oberlab/xmas-badge/edu_resources/exercises.pdf

## Lötübung xmas-badge

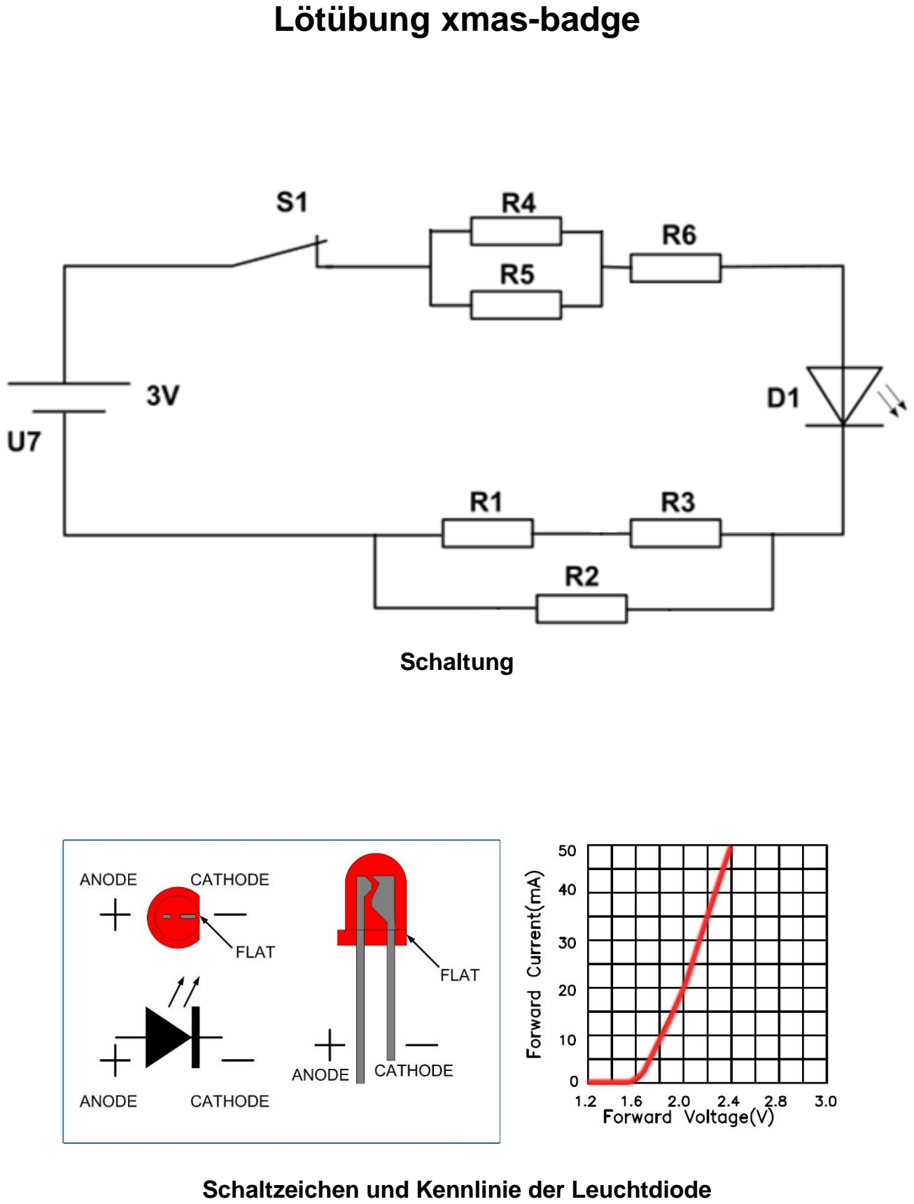
[picture p5: page 1]

Schaltung

Schaltzeichen und Kennlinie der Leuchtdiode

Aufgaben

1. Bestücke den Batteriehalter, den Schalter S1 und die rote LED D1.
2. Überbrücke R2.
3. Bei einer Batteriespannung von 3V soll der LED-Strom 30mA betragen. Berechne

den Wert für R6.

4. Löte R6 ein.
5. Schließe einen Strommesser anstelle von R4 an und überprüfe den LED-Strom.
6. Trenne die Brücke von R2 auf und bestimme den Widerstand R2 bei einen LED-

Strom von 12mA.

7. Löte R2 ein.
8. Überprüfe den Gesamtstrom.
9. Überbrücke R3.
10. Durch R1 soll der LED-Strom auf 15mA steigen. Welchen Wert hat R1?
11. Löte R1 ein und überprüfe den LED-Strom.
12. Entferne die Brücke bei R3.
13. Der Gesamtstrom soll sich durch R3 auf 13mA ändern. Welchen Wert hat R3?
14. Entferne den Strommesser bei R4.
15. Der Gesamtstrom soll sich durch die Bestückung von R4 und R5 auf 10mA ändern.

Welchen Wert hat R4 und R5?
