oberlab/xmas-badge/.svg2shenzhen-cache/images/F.Cu_g842.png

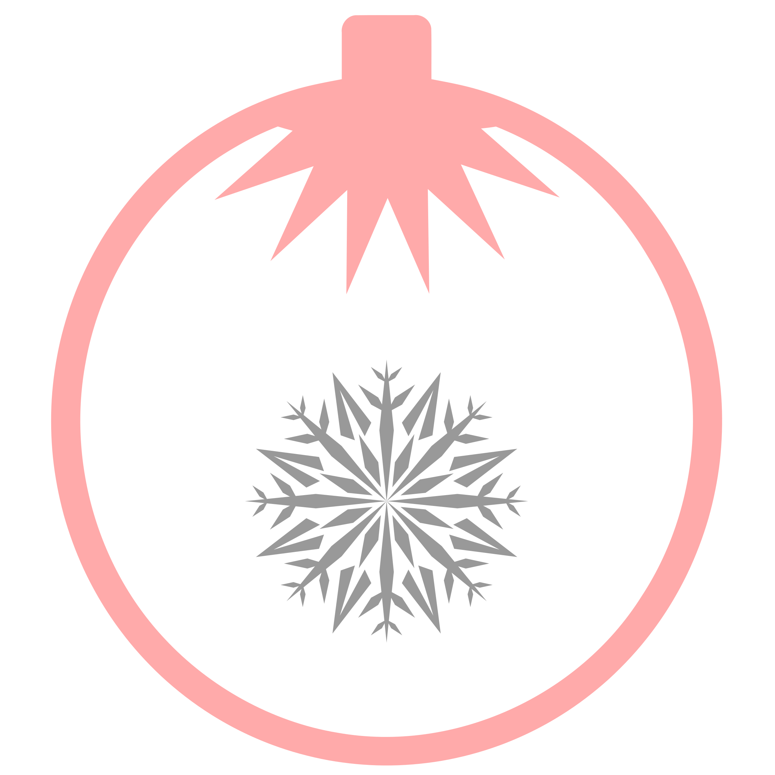
.svg2shenzhen-cache/images/F.Cu_g842.png
