oberlab/xmas-badge/.svg2shenzhen-cache/images/F.SilkS_g846.png

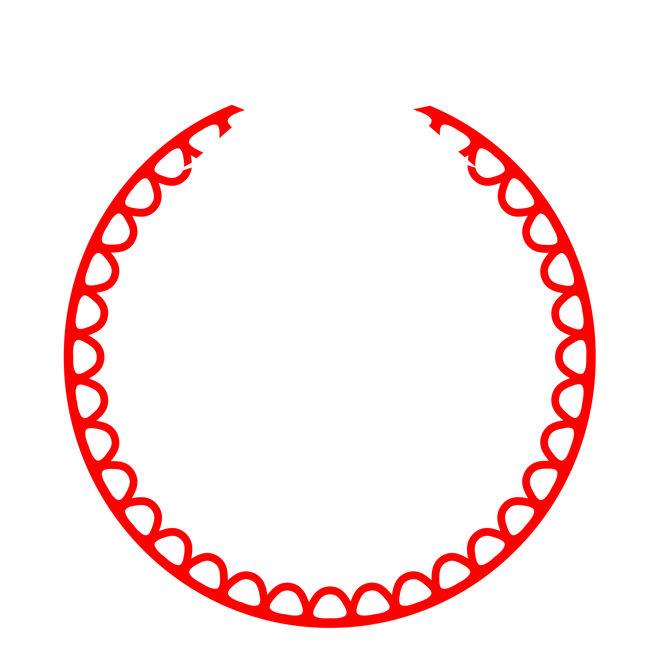
.svg2shenzhen-cache/images/F.SilkS_g846.png
