oberlab/xmas-badge/edu_resources/instructions.pdf

Lötübung xmas-badge

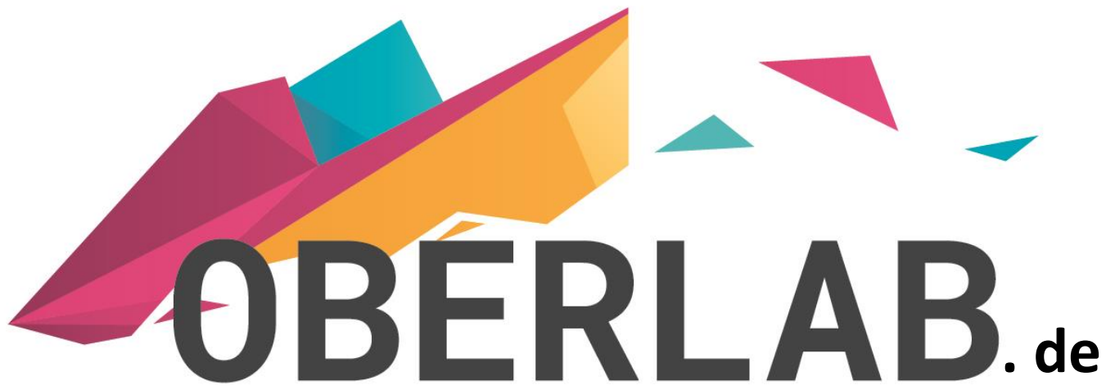
[picture p8: figure]
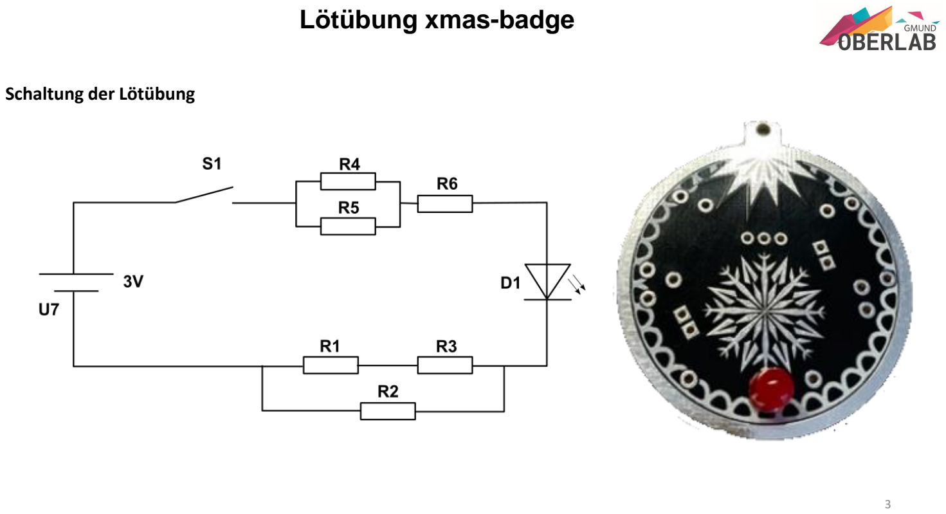
[picture p9: page 2]

Lötübung xmas-badge

Schaltung der Lötübung

Lötübung xmas-badge

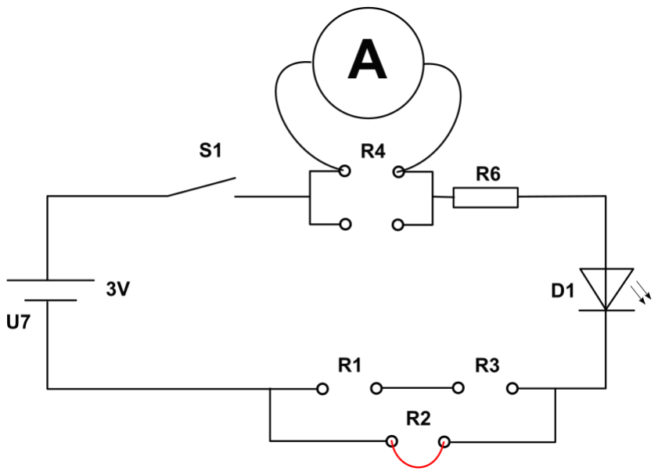
[picture p10: figure]

Ersatzschaltbild Aufgabe 1 - 5

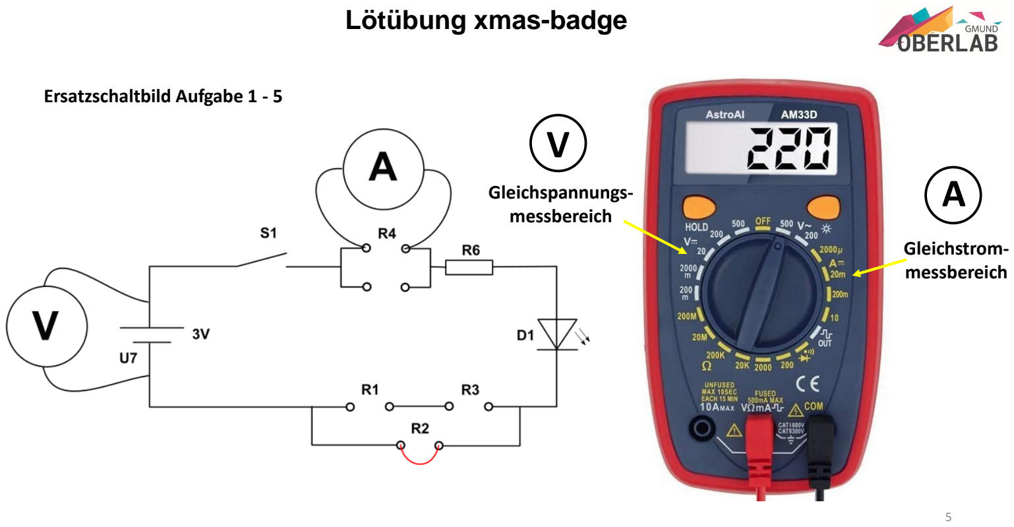
[picture p11: page 4]

Lötübung xmas-badge

Ersatzschaltbild Aufgabe 1 - 5

Gleichspannungs-messbereich
Gleichstrom-messbereich

V
A

Lötübung xmas-badge

Die LED:

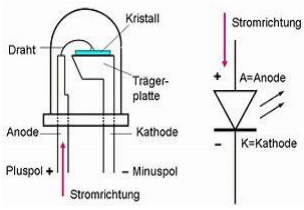
[picture p12: figure]

Lötübung xmas-badge

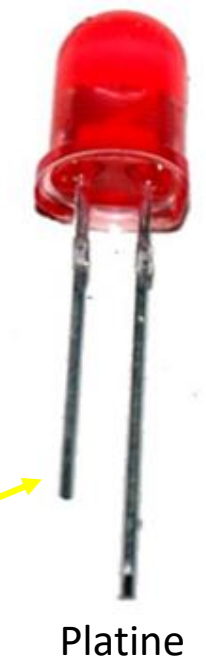
[picture p13: figure]
Platine

Die LED:

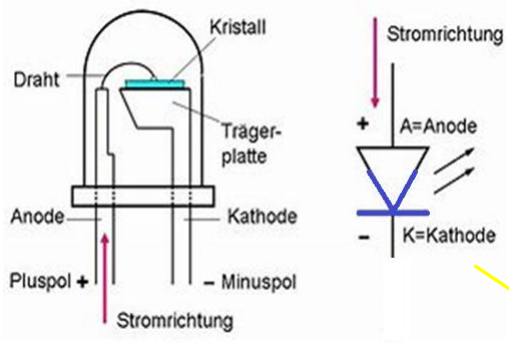
[picture p14: figure]

Lötübung xmas-badge

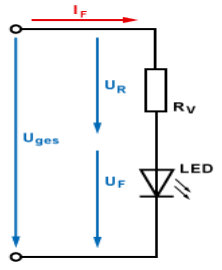
[picture p15: figure]

Mit einem Vorwiderstand wird der Durchlassstrom IF , der durch die Leuchtdiode fließt, begrenzt.
Bei der Widerstandsbestimmung muss die jeweilige Durchlassspannung UF berücksichtigt werden.

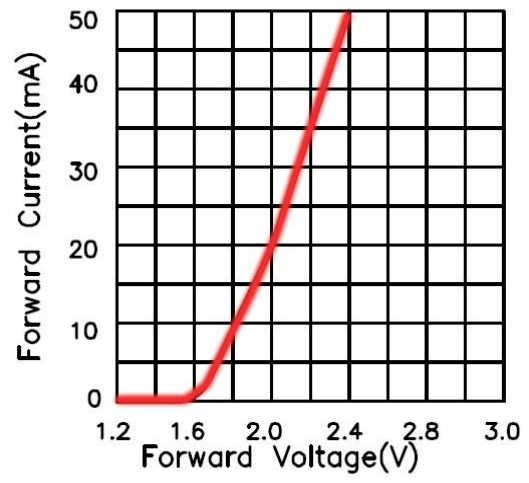
[picture p16: figure]

Rv =

Uges − UF
IF

Lötübung xmas-badge

Mit einem Vorwiderstand wird der Durchlassstrom IF , der durch die Leuchtdiode fließt, begrenzt.
Bei der Widerstandsbestimmung muss die jeweilige Durchlassspannung UF berücksichtigt werden.

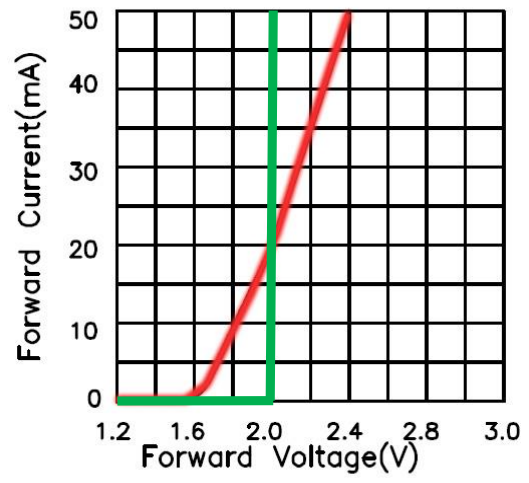
[picture p17: figure]

Rv =

Uges − UF
IF

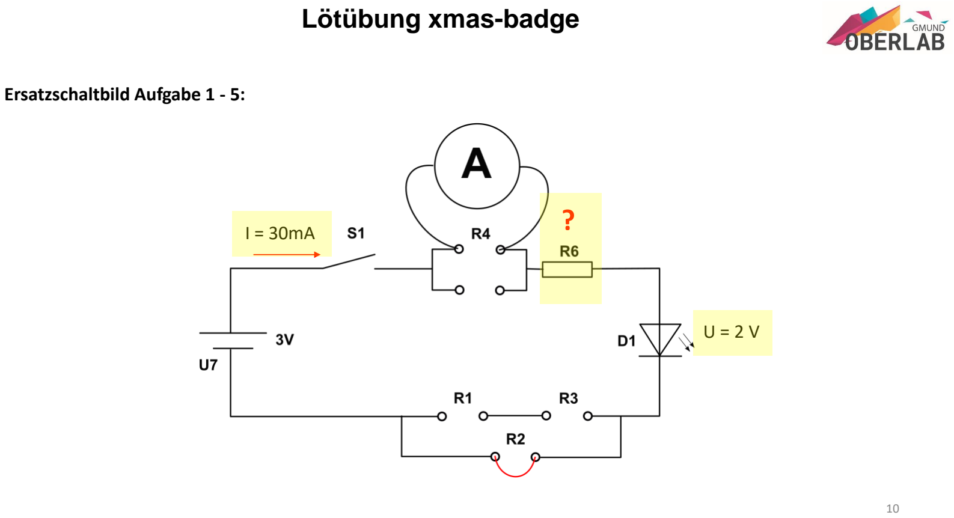
[picture p18: page 9]

Lötübung xmas-badge

Ersatzschaltbild Aufgabe 1 - 5:

I = 30mA | ?

U = 2 V

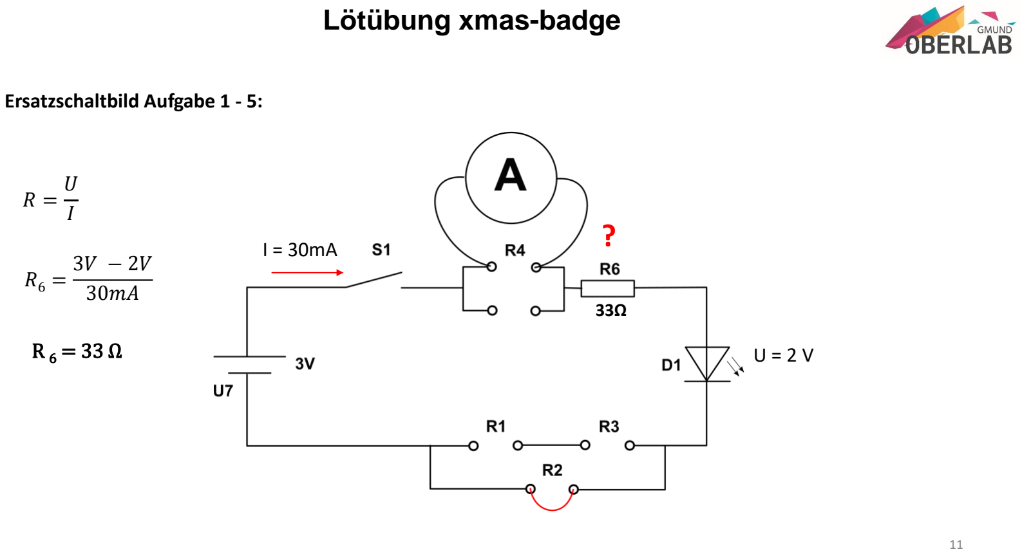
[picture p19: page 10]

Lötübung xmas-badge

Ersatzschaltbild Aufgabe 1 - 5:

R =

U
I

R6 =

3V − 2V
30mA

R 6 = 33 Ω

I = 30mA | ?

U = 2 V

33Ω

Lötübung xmas-badge

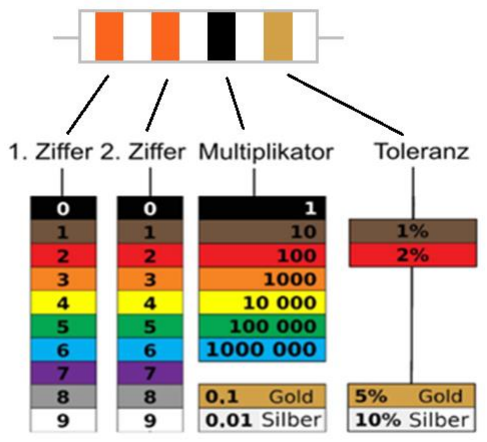
[picture p20: figure]

Der Farbcode:

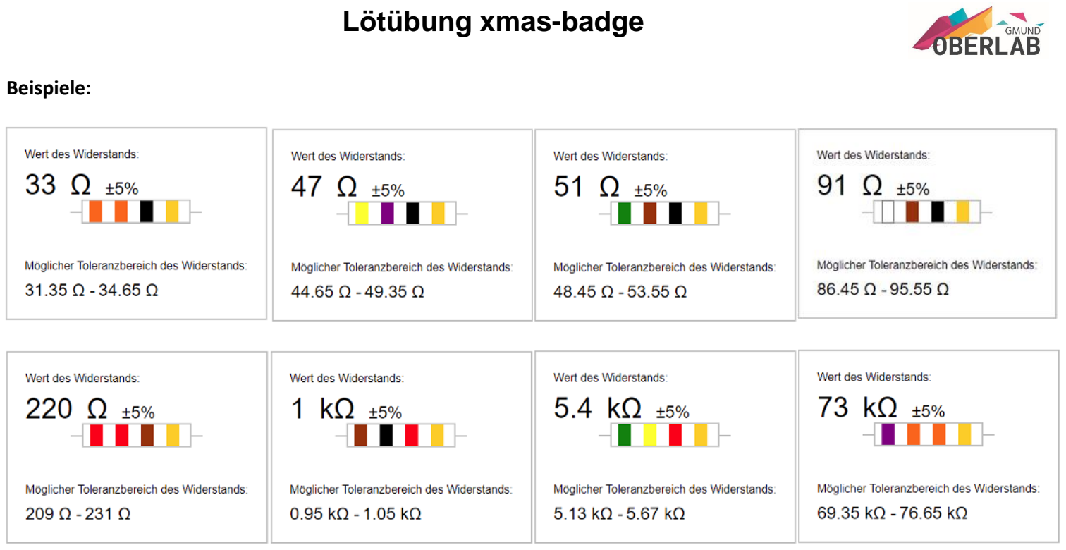
[picture p21: page 12]

Lötübung xmas-badge

13

Beispiele:

E-6 20% | E-6 20% | E-12 10% | E-24 5%
1 | 1 | 1 | 1
| | | 1,1
| | 1,2 | 1,2
| | | 1,3
1,5 | 1,5 | 1,5 | 1,5
| | | 1,6
| | 1,8 | 1,8
| | | 2
2,2 | 2,2 | 2,2 | 2,2
| | | 2,4
| | 2,7 | 2,7
| | | 3
3,3 | 3,3 | 3,3 | 3,3
| | | 3,6
| | 3,9 | 3,9
| | | 4,3
4,7 | 4,7 | 4,7 | 4,7
| | | 5,1
| | 5,6 | 5,6
| | | 6,2
6,8 | 6,8 | 6,8 | 6,8
| | | 7,5
| | 8,2 | 8,2
| | | 9,1

E-Reihen

Eine E-Reihe ist eine genormte Folge von Eigenschaftswerten elektrischer

Bauelemente. Die Werte der E-Reihen ergeben sich aus der Renard-Serie. Die im

Handel erhältliche Widerstände, Kondensatoren, Spulen oder Zener-Dioden haben

meist nominelle Werte aus einer E-Reihe. Eine E-Reihe deckt dabei den Wertebereich

so ab, dass das Verhältnis aufeinanderfolgender Werte möglichst gleich groß ist.

Außerdem sind die Werte so gewählt, dass sich die Ziffernfolgen in jeder Dekade

wiederholen.

In der Norm DIN IEC 60063 sind sieben E-Reihen definiert: E3, E6, E12, E24, E48, E96

und E192. Dabei gibt die Zahl hinter dem E an, wie viele Werte die Reihe innerhalb

einer Dekade enthält. Die Norm trat im Dezember 1985 unter dem Titel Vorzugsreihen

für die Nennwerte von Widerständen und Kondensatoren in Kraft. Sie stimmt inhaltlich

mit der internationalen Norm IEC 60063 von 1963 überein. Je größer die E-Reihe,

desto kleiner müssen die Toleranzen der Bauteile sein, da diese sonst benachbarte

Werte überlagern könnten.

Lötübung xmas-badge

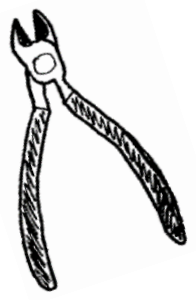
[picture p22: figure]
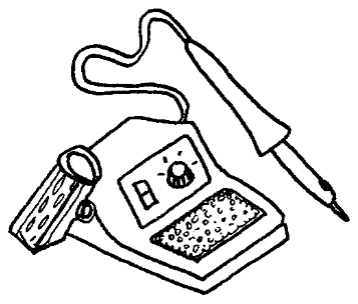
[picture p23: figure]
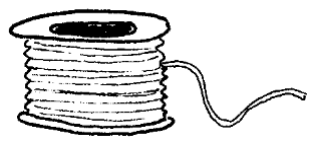
[picture p24: figure]

Lötkolben | Lötzinn | Seitenschneider

Welches Werkzeug benötigen wir?

Lötübung xmas-badge

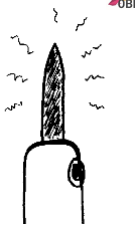
[picture p25: figure]

- Die Lötkolbenspitze wird sehr heiß!
- Kein Kontakte mit der Lötspitze bei dir

oder deinen Nachbarn!

- Stecke den Lötkolben nach dem Gebrauch

wieder in den Lötkolbenständer!

Worauf achten wir?

Lötübung xmas-badge

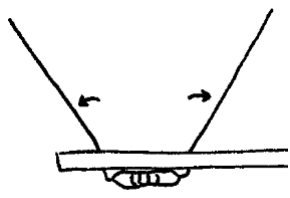
[picture p26: figure]

- Wir beginnen mit den kleinen Bauteilen.
- Wir stecken die Bauteilfüße in die Platine

Und biegen sie um.

- Dadurch werden sie vor dem Löten in der

Platine gehalten.

Wie beginnen wir?

Lötübung xmas-badge

- Vor dem Löten streifen wir die

Lötkolbenspitze auf der Stahlwolle ab.

Wie beginnen wir?

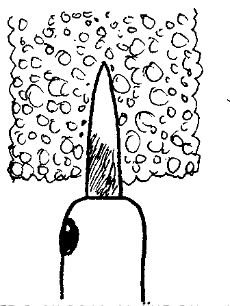
[picture p27: figure]
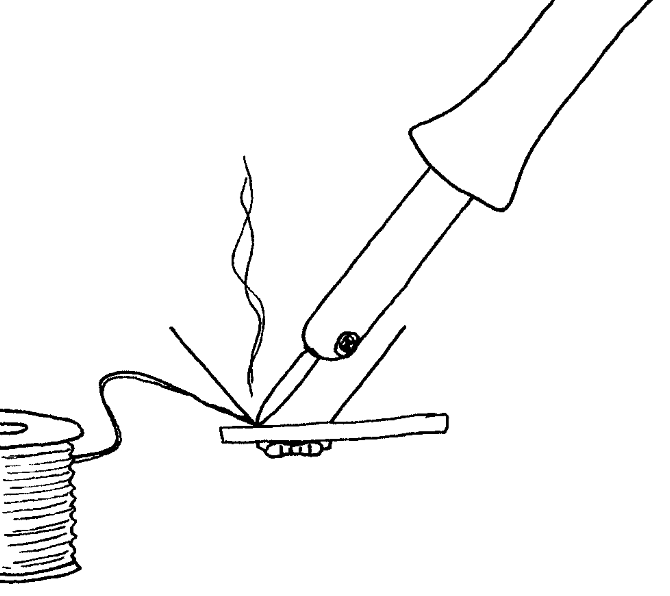
[picture p28: figure]

- Wir halten den Lötkolben und das Lötzinn an die

Lötstelle und blasen den Rauch weg.

- Das Lötzinn schmilzt und verläuft.

Lötübung xmas-badge

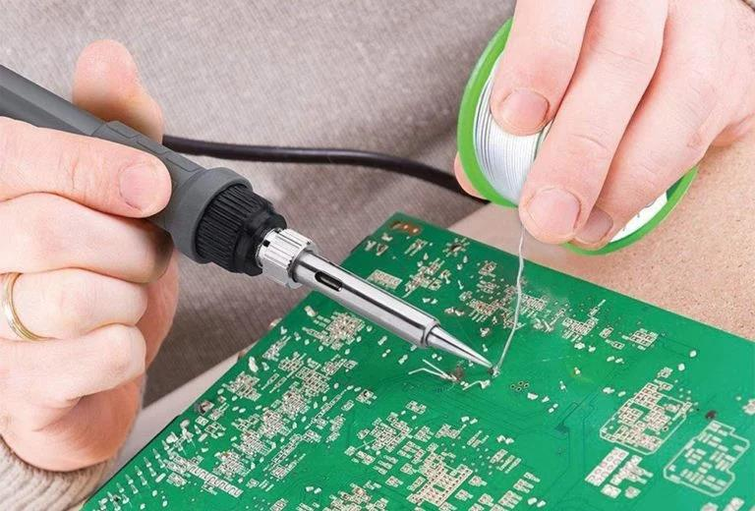
[picture p29: figure]

Löten:

Lötübung xmas-badge

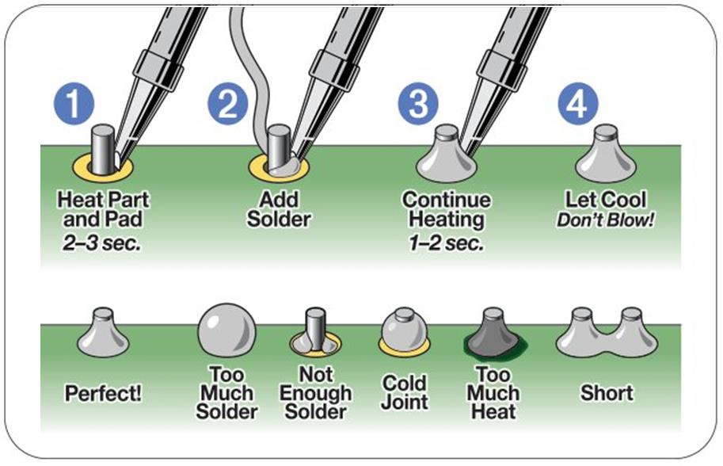
[picture p30: figure]

Lötübung xmas-badge

Lötübung xmas-badge

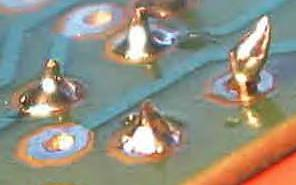
[picture p31: figure]
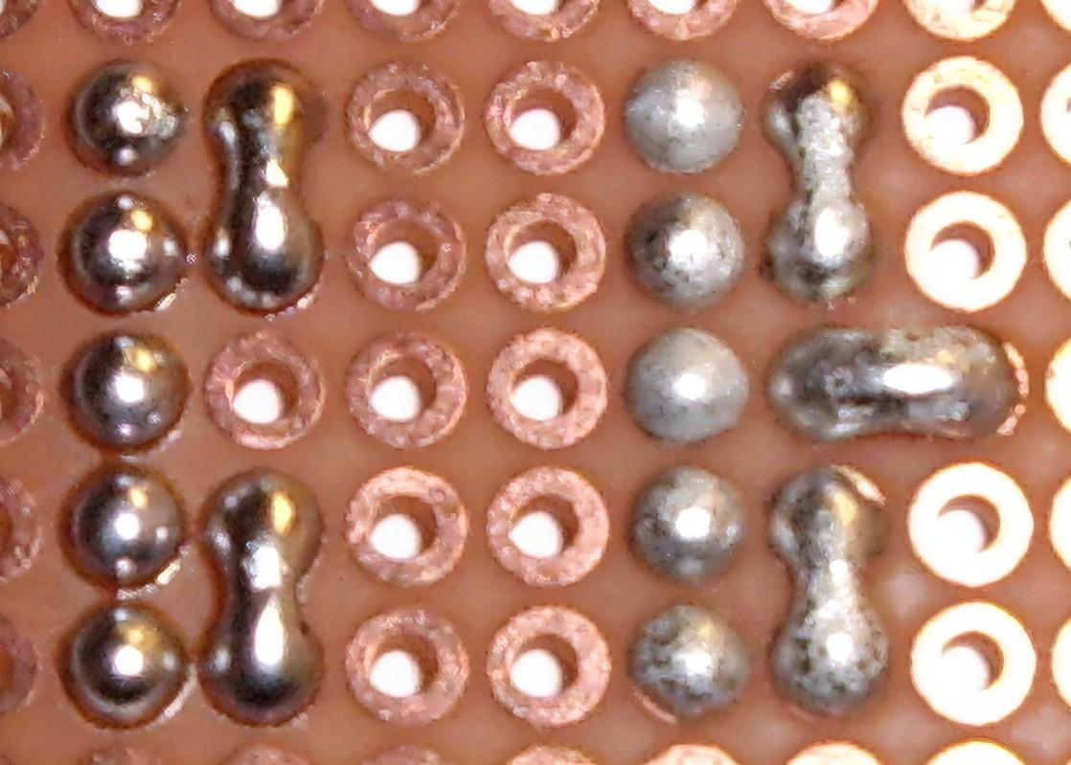
[picture p32: figure]

Nach dem Löten den Lötkolben wieder in den Lötkolbenständer stecken.

Lötübung xmas-badge

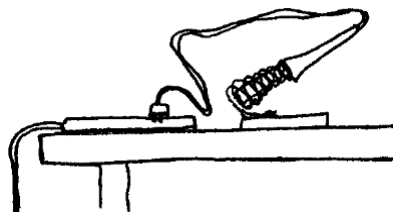
[picture p33: figure]
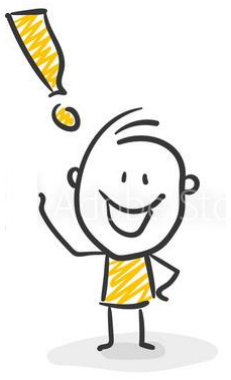
[picture p34: figure]

Ist das Bauteil korrekt eingelötet, wird der Bauteilfuß mit dem Seitenschneider

Lötübung xmas-badge

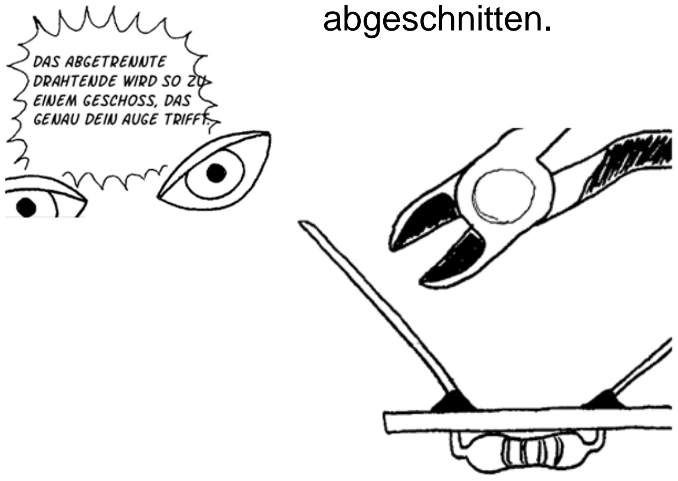
[picture p35: figure]
abgeschnitten.

Damit der Bauteildraht beim Abzwicken nicht wegspritzt, halte den Bauteildraht

beim abzwicken fest oder halte die Hand als Schutz darüber.

Lötübung xmas-badge

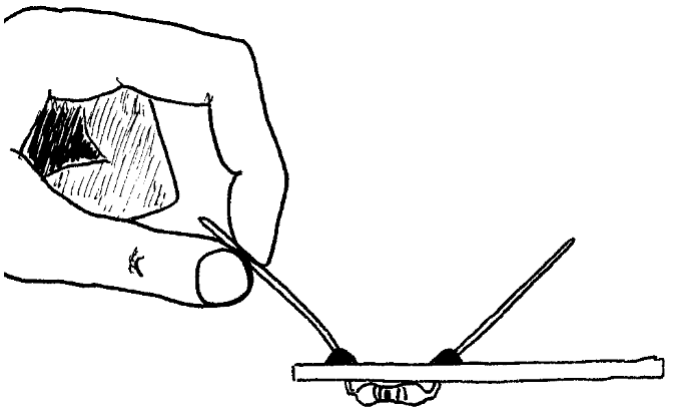
[picture p36: figure]
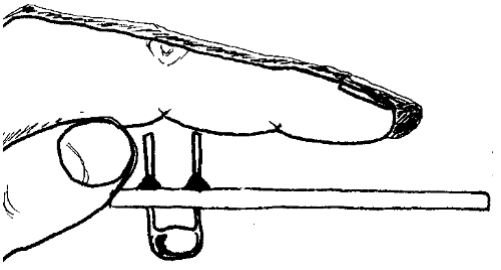
[picture p37: figure]

Nach dem Löten Hände waschen!

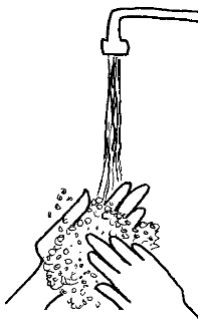
[picture p38: figure]

Das Lötzinn beinhaltet ein Flussmittel und

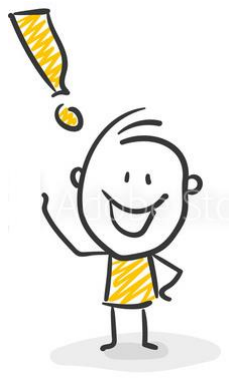
[picture p39: figure]

besteht aus verschiedenen Metallen.

Deshalb: Nach dem Löten Hände gründlich

waschen!

Während du lötest wird nichts gegessen.

Lötübung xmas-badge

Lötübung xmas-badge
Und los gehts!

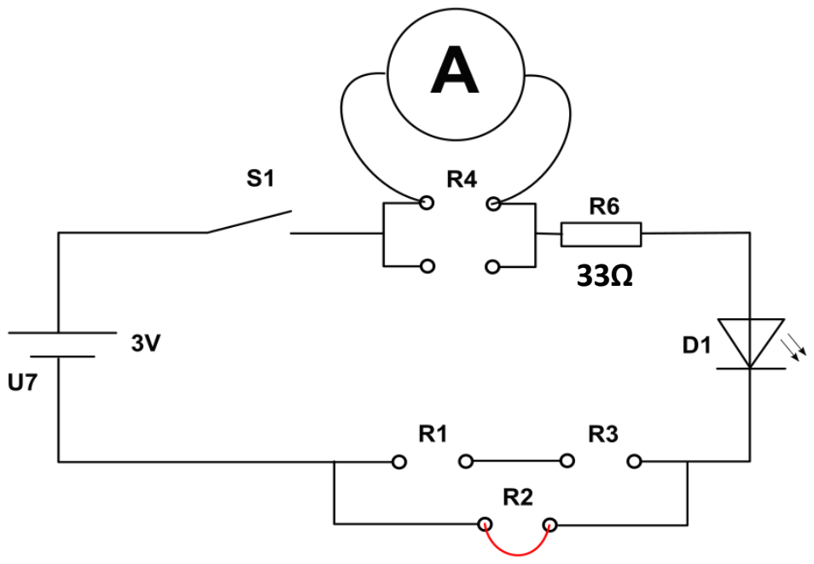
[picture p40: figure]

1. Bestücke den Batteriehalter, den Schalter S1 und die

rote LED D1.

2. Überbrücke R2 mit einer Drahtbrücke.
3. Bei einer Batteriespannung von 3V soll der LED-Strom

30mA betragen. Berechne den Wert für R6.

4. Löte R6 ein.
5. Schließe einen Strommesser zwischen U1 und U2 an

und überprüfe den LED-Strom.

Lötübung xmas-badge

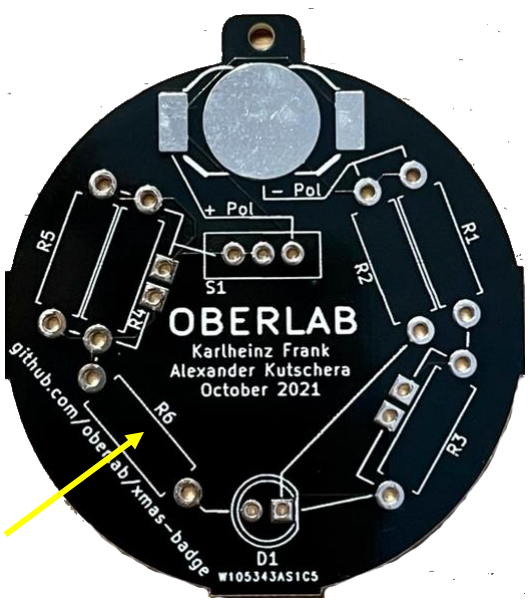
[picture p41: figure]

R6 33Ω

R6 einlöten:

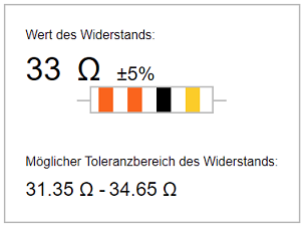
[picture p42: figure]

Lötübung xmas-badge
Und los gehts!

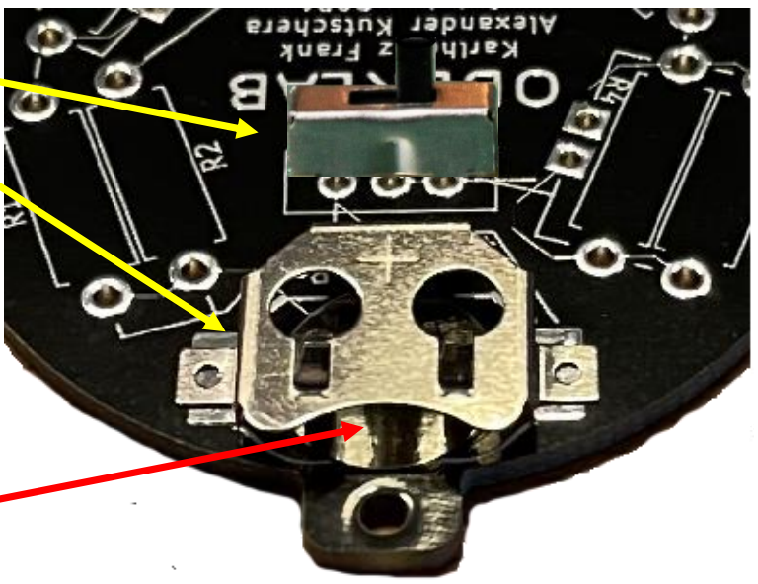
[picture p43: figure]

S1
und
Batteriehalter
einlöten:

Öffnung
beachten!

Lötübung xmas-badge

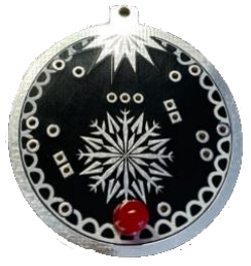
[picture p44: figure]

LED einlöten:

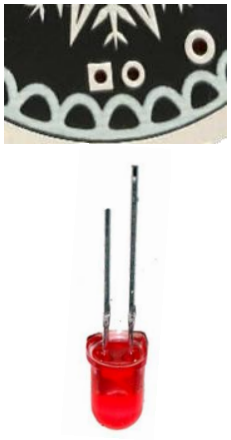
[picture p45: figure]

Lötübung xmas-badge

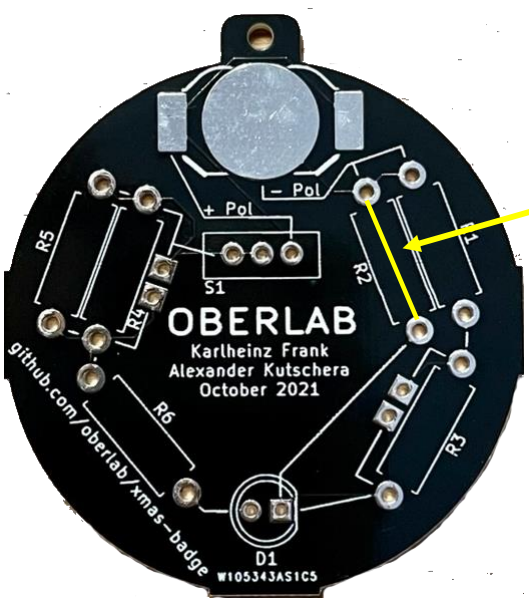
[picture p46: figure]

### R2 überbrücken

Stromkreis schließen:

Lötübung xmas-badge

### Strom

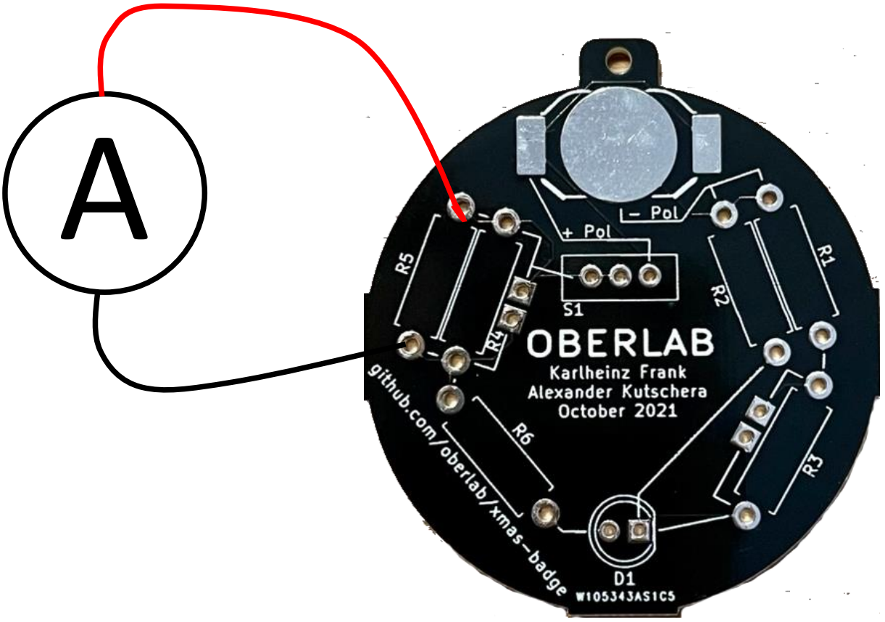
[picture p47: figure]

### messen A

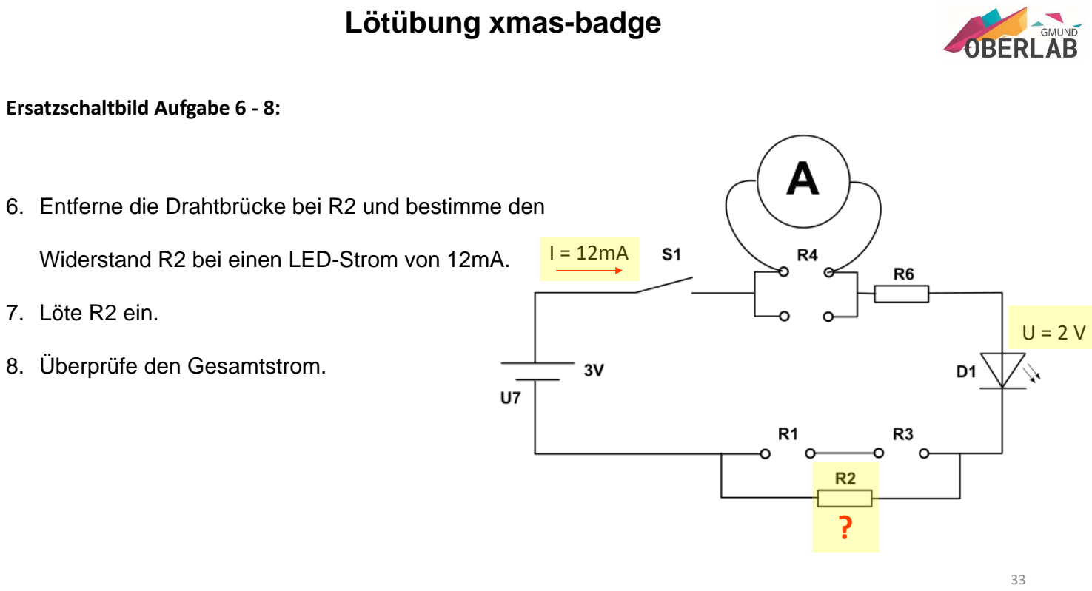
[picture p48: page 31]

Lötübung xmas-badge

Ersatzschaltbild Aufgabe 6 - 8:

I = 12mA

?

6. Entferne die Drahtbrücke bei R2 und bestimme den

Widerstand R2 bei einen LED-Strom von 12mA.

7. Löte R2 ein.
8. Überprüfe den Gesamtstrom.

U = 2 V

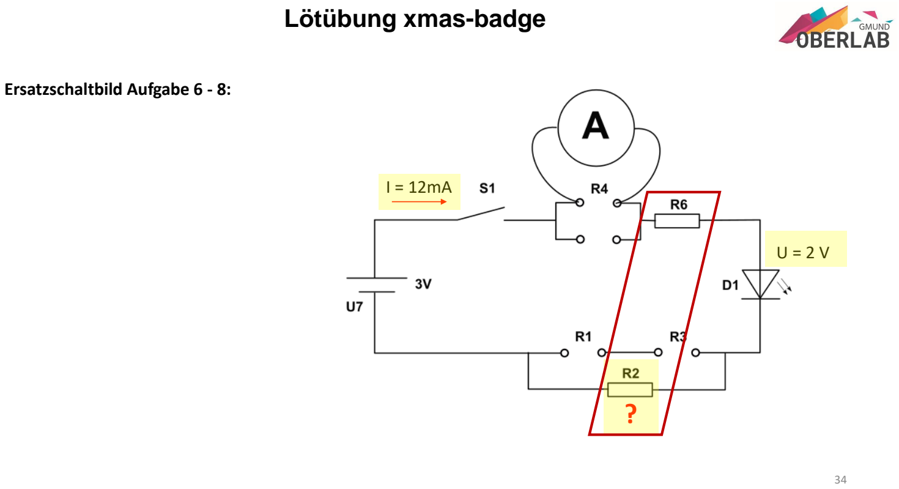
[picture p49: page 32]

Lötübung xmas-badge

Ersatzschaltbild Aufgabe 6 - 8:

I = 12mA

?

U = 2 V

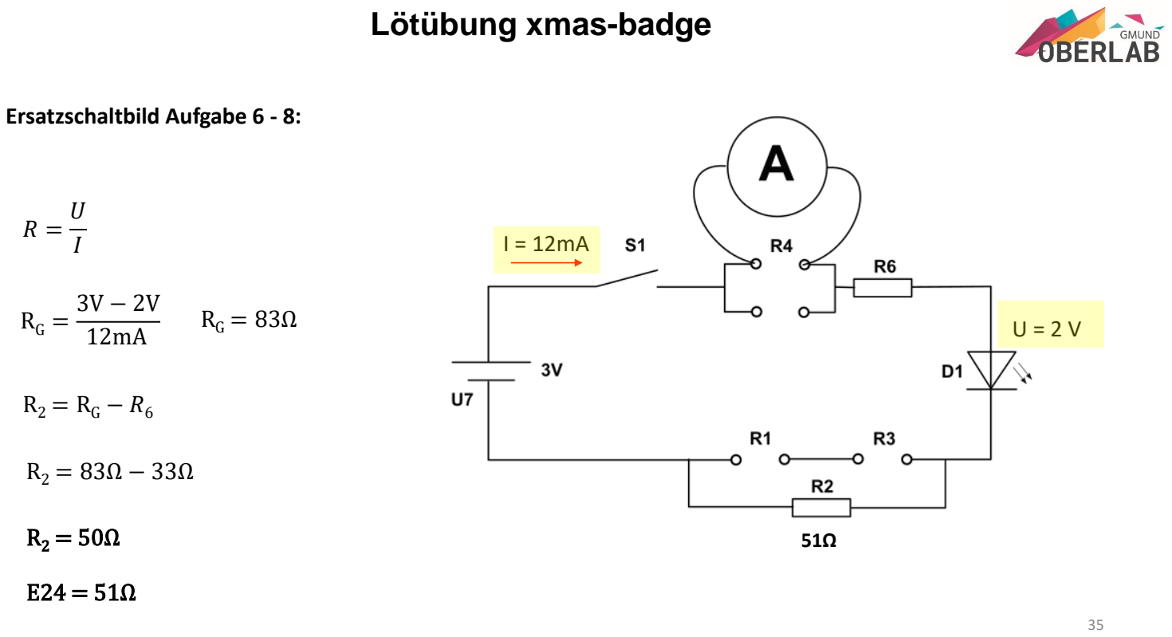
[picture p50: page 33]

Lötübung xmas-badge

Ersatzschaltbild Aufgabe 6 - 8:

I = 12mA

U = 2 V

R2 = 50Ω

R2 = RG − R6

R2 = 83Ω − 33Ω

E24 = 51Ω

51Ω

RG = | RG = 83Ω

3V − 2V
12mA

R =

U
I

Lötübung xmas-badge

Farbcode R2:

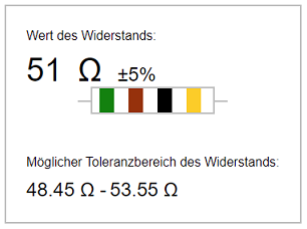
[picture p51: figure]
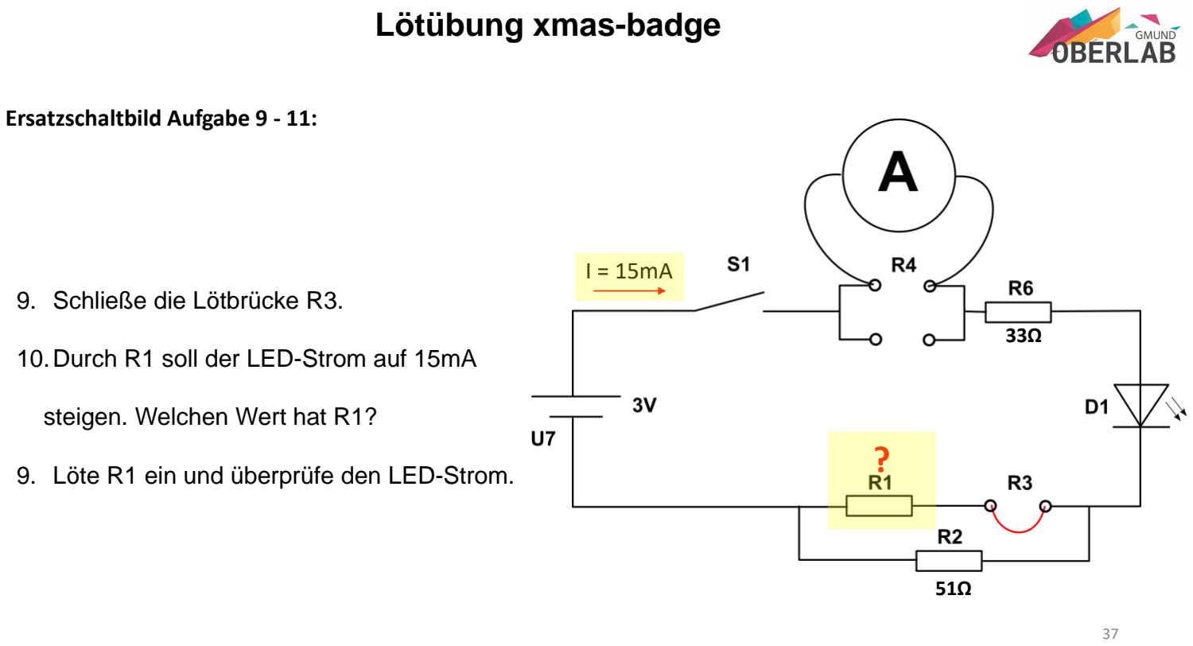
[picture p52: page 35]

Lötübung xmas-badge

Ersatzschaltbild Aufgabe 9 - 11:

33Ω

51Ω

I = 15mA

?

9. Schließe die Lötbrücke R3.

10.Durch R1 soll der LED-Strom auf 15mA

steigen. Welchen Wert hat R1?

9. Löte R1 ein und überprüfe den LED-Strom.

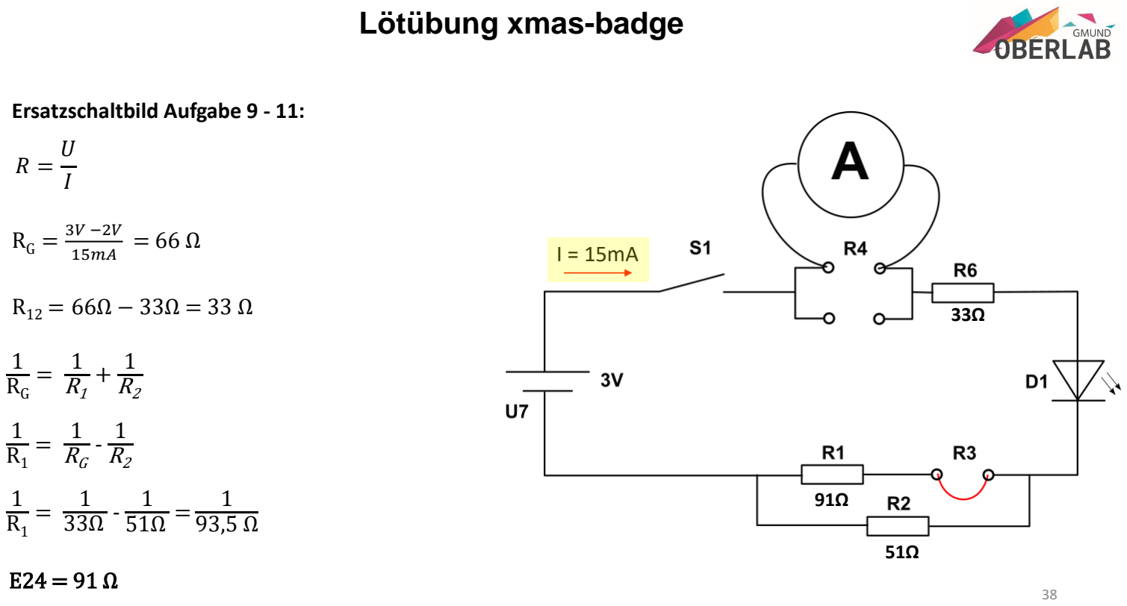
[picture p53: page 36]

Lötübung xmas-badge

Ersatzschaltbild Aufgabe 9 - 11:

33Ω

51Ω

I = 15mA

rechte Maustaste

R =

U
I

RG =

3V −2V
15mA

= 66 Ω

R12 = 66Ω − 33Ω = 33 Ω

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
93,5 Ω

E24 = 91 Ω

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
Lötübung xmas-badge

Farbcode R1:

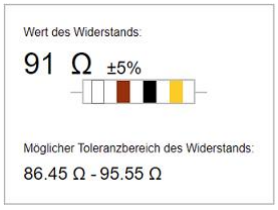
[picture p54: figure]

Lötübung xmas-badge

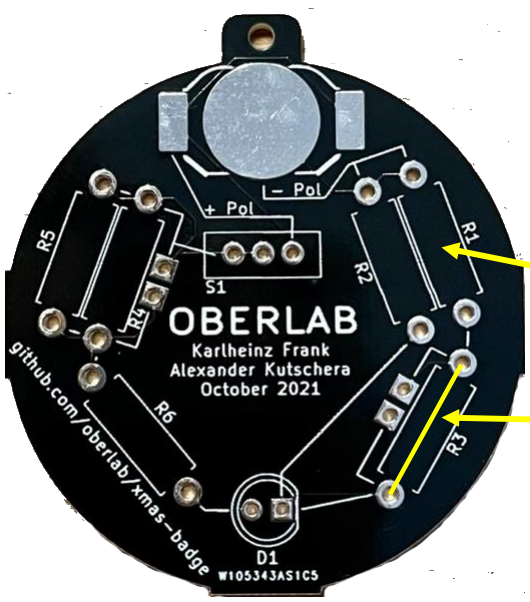
[picture p55: figure]

R1 91Ω einlöten

R3 überbrücken

R1 einlöten

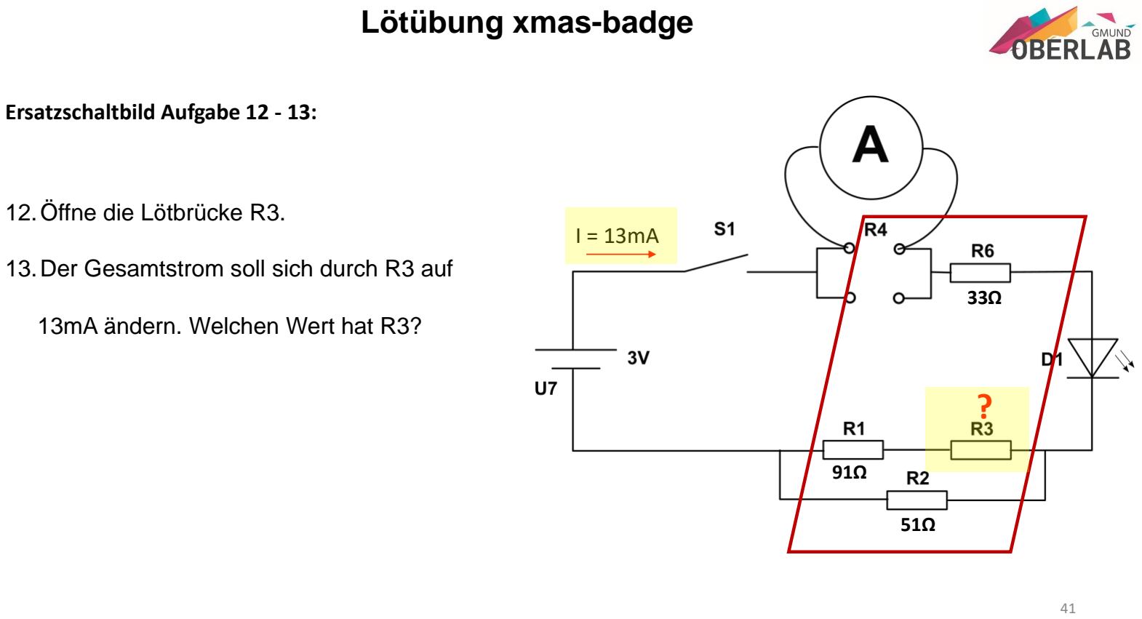
[picture p56: page 39]

Lötübung xmas-badge

Ersatzschaltbild Aufgabe 12 - 13:

I = 13mA

51Ω

33Ω

91Ω

?

12.Öffne die Lötbrücke R3.

13.Der Gesamtstrom soll sich durch R3 auf

13mA ändern. Welchen Wert hat R3?

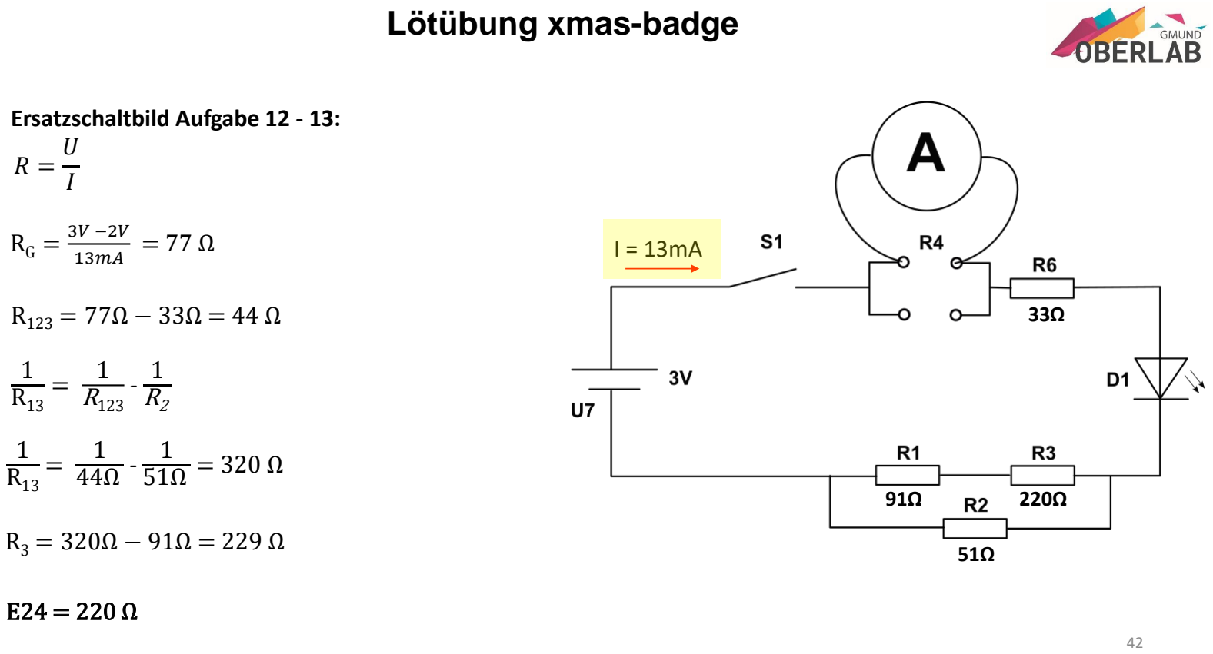
[picture p57: page 40]

Lötübung xmas-badge

Ersatzschaltbild Aufgabe 12 - 13:

I = 13mA

51Ω

33Ω

91Ω

rechte Maustaste

R =

U
I

RG =

3V −2V
13mA

= 77 Ω

R123 = 77Ω − 33Ω = 44 Ω

1
R13

=

1
44Ω

1
51Ω

= 320 Ω

E24 = 220 Ω

R3 = 320Ω − 91Ω = 229 Ω

1
R13

=

1
R123

1
R2

220Ω

Lötübung xmas-badge

Farbcode R3:

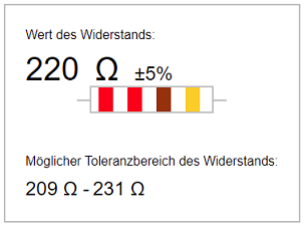
[picture p58: figure]

Lötübung xmas-badge

Ersatzschaltbild Aufgabe 14-15:

14.Entferne den Strommesser. | ?

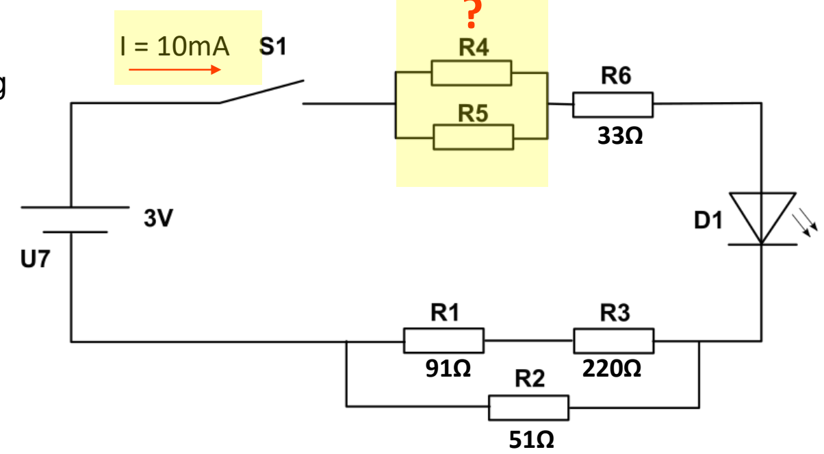
[picture p59: figure]

15.Der Gesamtstrom soll sich durch die Bestückung

von R4 und R5 auf 10mA ändern. Welchen Wert

haben R4 und R5?

Lötübung xmas-badge

Ersatzschaltbild Aufgabe 14-15:

14.Entferne den Strommesser. | ?

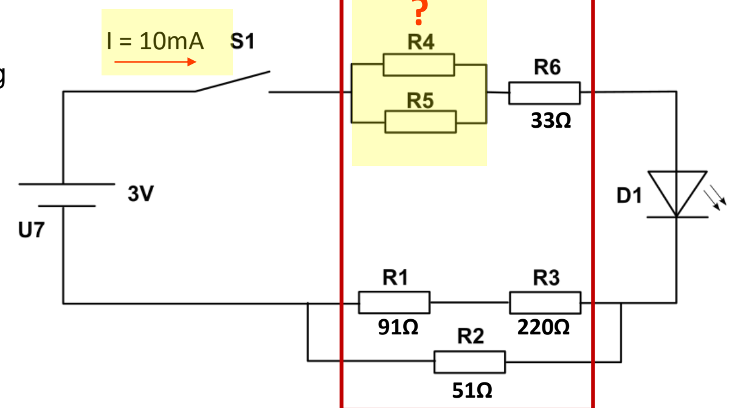
[picture p60: figure]

15.Der Gesamtstrom soll sich durch die Bestückung

von R4 und R5 auf 10mA ändern. Welchen Wert

haben R4 und R5?

Lötübung xmas-badge

Ersatzschaltbild Aufgabe 14-15:

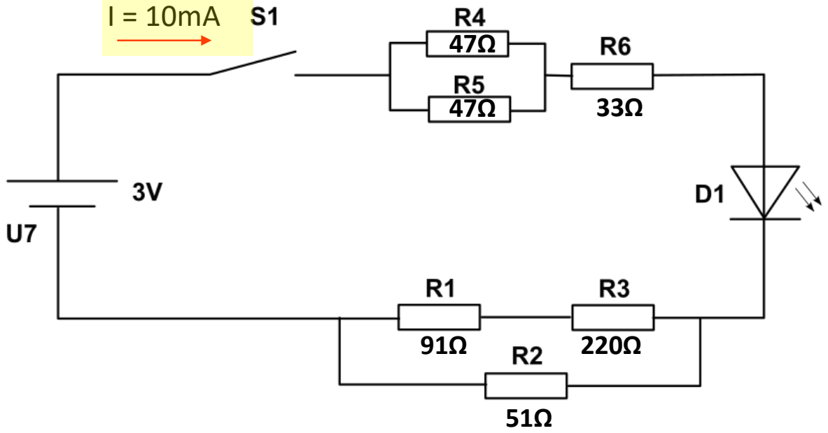
[picture p61: figure]

rechte Maustaste

R =

U
I

RG =

3V−2V
10mA = 100 Ω

R4 = 46 Ω

R45 = 100Ω − 33Ω − 44Ω = 23 Ω

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
= 23 Ω

E24 = 47Ω

R5 = 46 Ω

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
Lötübung xmas-badge

Farbcode R4 und R5:

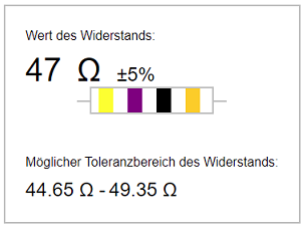
[picture p62: figure]

Lötübung xmas-badge

Kontrolle:

ILED =

U
R

=

1 V
100,31Ω

= 9,96mA

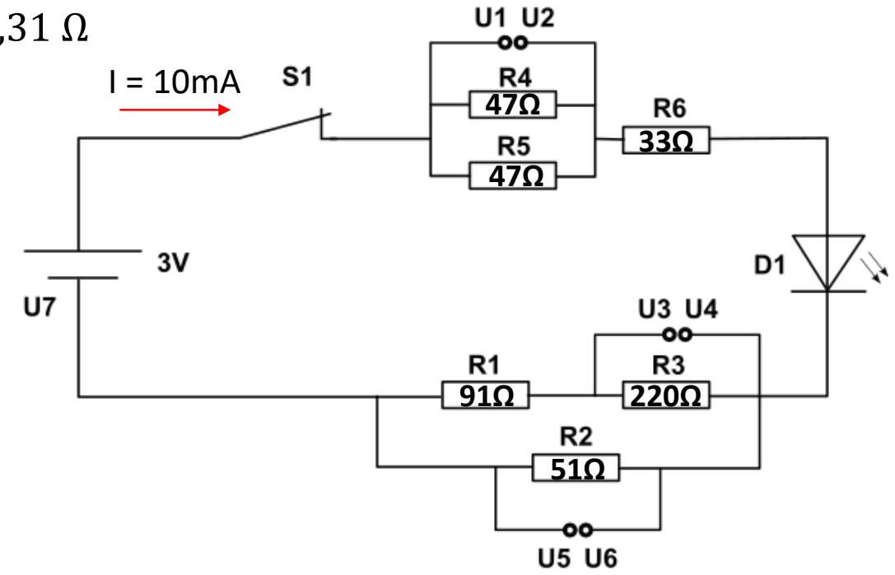
[picture p63: figure]

RG = 23,5Ω + 33Ω + 43,8Ω = 100,31 Ω
