oberlab/xmas-badge/kicad_files/xmas-badge.kicad_pcb

## KiCad design kicad_files/xmas-badge.kicad_pcb (2021-10-23)

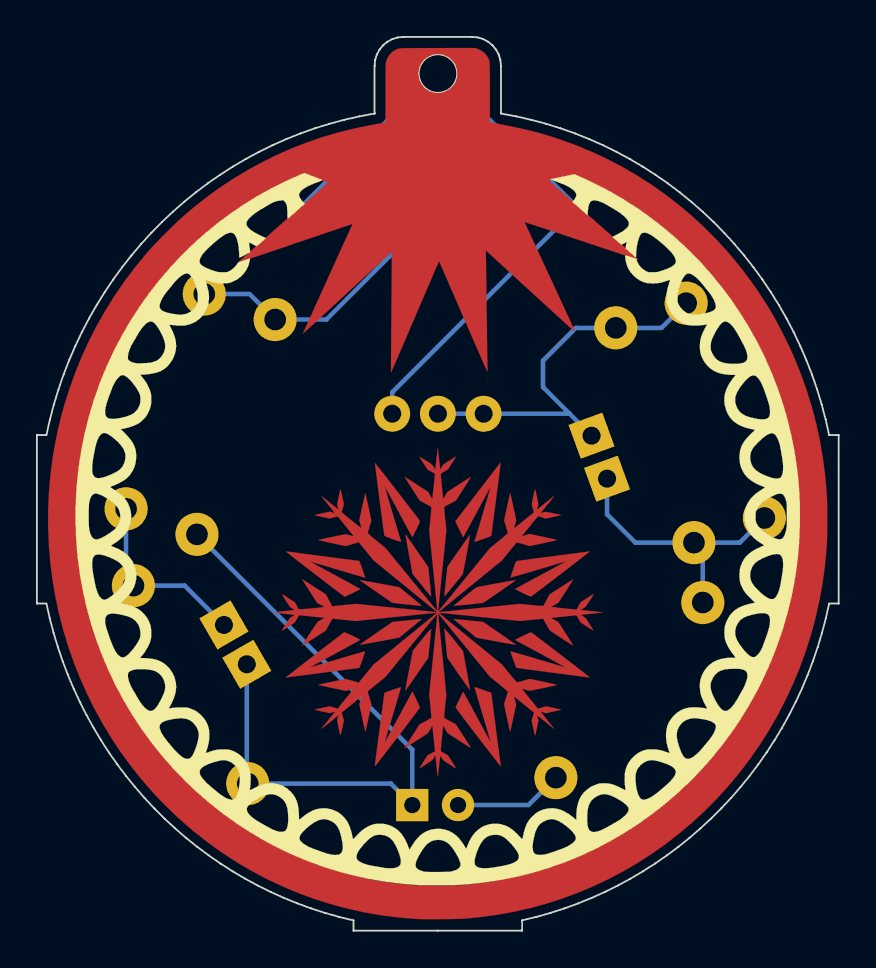
[picture p64: board xmas-badge.kicad_pcb from above]

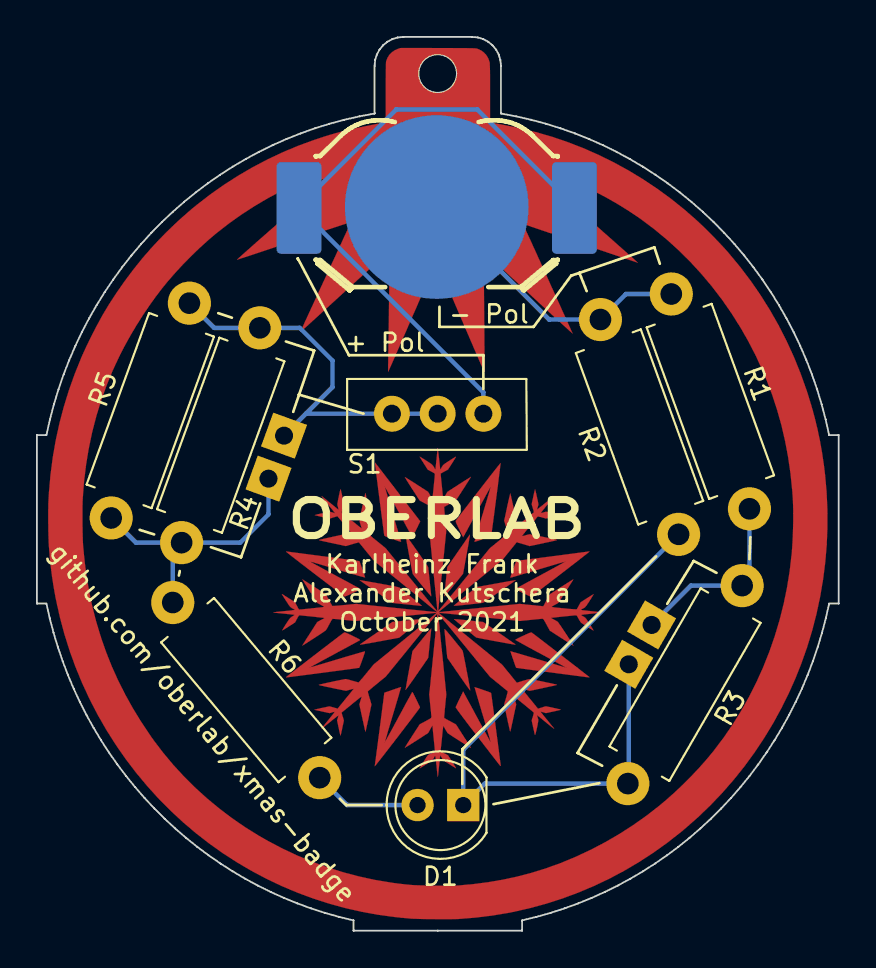
[picture p65: board xmas-badge.kicad_pcb from below]

Board: 2 copper layers, 44.5 x 49.7 mm, 14 parts (10 on the bottom side), 7 nets.

Parts:
 : MountingHole_2.1mm
 #2,  #3,  #4,  #5: LP
D1: LED; LED_D5.0mm
R1, R2, R3, R4, R5, R6: R; R_Axial_DIN0411_L9.9mm_D3.6mm_P12.70mm_Horizontal
S1: Micro_Schalter; Micro_SchalterKHF
U1: BAT_HLD_2032; BAT-HLD-012-SMT

Connections:
unnamed: #3.1, D1.1, R2.1, R3.1
unnamed: D1.2, R6.1
unnamed: #2.1, R1.1, R3.2
unnamed: R1.2, R2.2, U1.1
unnamed: #5.1, R4.1, R5.1, R6.2
unnamed: #4.1, R4.2, R5.2, S1.2, S1.3
unnamed: S1.1, U1.2, U1.3
