oberlab/xmas-badge/(commit log)

2021-10-07 added KiCad files
    [xmas-badge.kicad_pcb, xmas-badge.sch]
2021-10-23 first small version
    [xmas-badge.kicad_pcb, xmas-badge.sch]
2021-10-23 increased size, component placement
    [xmas-badge-B_Adhes.gbr, xmas-badge-B_CrtYd.gbr, xmas-badge-B_Cu.gbr, xmas-badge-B_Fab.gbr, xmas-badge-B_Mask.gbr, xmas-badge-B_Paste.gbr, xmas-badge-B_SilkS.gbr, xmas-badge-Cmts_User.gbr]
2021-12-21 updated README, improved instructions
    [xmas-badge-B_Adhes.gbr, xmas-badge-B_CrtYd.gbr, xmas-badge-B_Cu.gbr, xmas-badge-B_Fab.gbr, xmas-badge-B_Mask.gbr, xmas-badge-B_Paste.gbr, xmas-badge-B_SilkS.gbr, xmas-badge-Cmts_User.gbr]
